emanuelelattanzi/virtual-sense.hardware/1.1.0/VirtualSense_FunctionalDiagram/pict/VirtualSense_MCU_brd_1.1.0.png

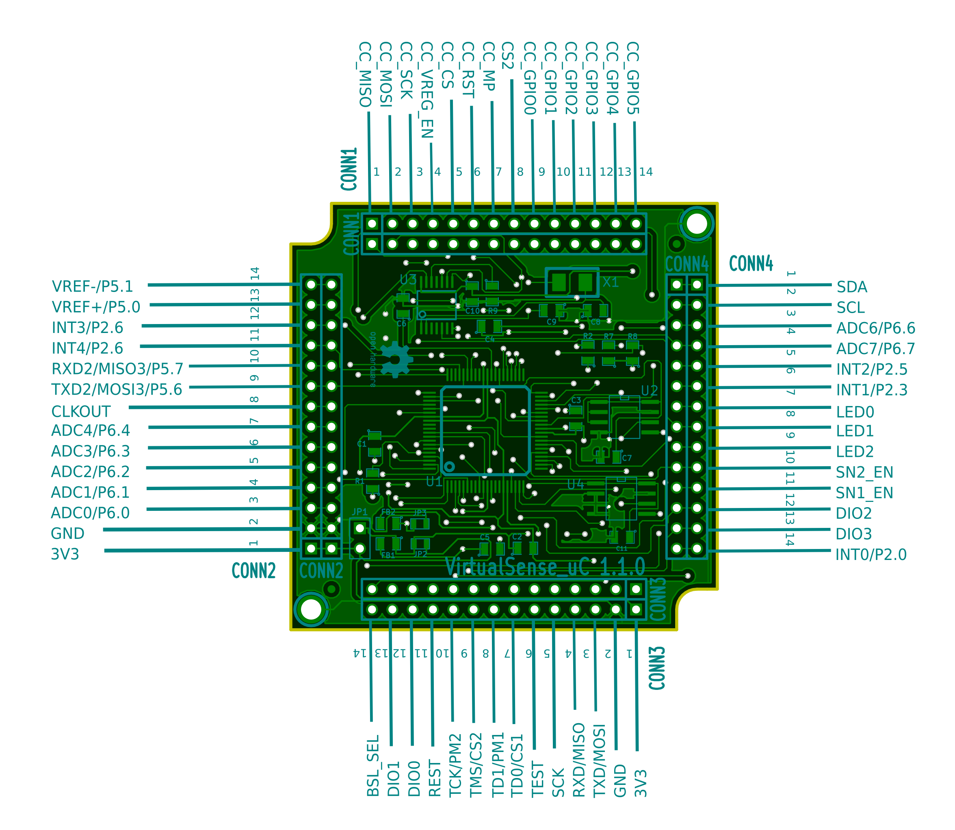
1.1.0/VirtualSense_FunctionalDiagram/pict/VirtualSense_MCU_brd_1.1.0.png
