emanuelelattanzi/virtual-sense.hardware/1.1.0/TestRadio/testradio_BOM_description.xls

Ref. | Part name | Pcs/unit | Description | Manufacturer | Part Number | Comment
ANTENNA
C7 | C_39P_0402_NP0_J_50 | 1 | Capacitor, 39p, 0402, NP0, 5%, 50V | Murata | GRM1555C1H390JZ01
C5 | C_82P_0402_NP0_J_50 | 1 | Capacitor, 82p, 0402, NP0, 5% 50V | Murata | GRM1555C1H820JZ01
C10-C8 | C_1P8_0402_NP0_C_50 | 1 | Capacitor, 1p8, 0402, NP0, +/-0.25pF 50V | Murata | GRM1555C1H1R8CZ01
C9 | C_1P5_0402_NP0_C_50 | 1 | Capacitor, 1p5, 0402, NP0, +-0.25pF, 50V | Murata | GRM1555C1H1R5CZ01
C13 | C_1P0_0402_NP0_C_50 | 3 | Capacitor, 1p, 0402, NP0, +/-0.25pF 50V | Murata | GRM1555C1H1R0CZ01
R6 | R_0_0402 | 1 | Resistor, 0 ohms, 0402 | Koa
U5 | SMA_SMD | 1 | SMA connector, straight SMD-mount | Hus-Tsan Group Taiwan
CC2520
U1 | CC2520 | 1 | Single-chip transceiver | Texas Instruments
C141;C151;C161;C271 | C_100N_0805_X7R_K_10 | 4 | Capacitor, 100n, 0805, X7R, 10%, 10V | Multicomp | MCCA001225
C1 | C_1U_0805_Y5V | 1 | Capacitor 1uF, 0805, Y5V | Multicomp | MCCA000549
C121;C131 | C_27P_0805_NP0_J_50 | 1 | Capacitor, 27p, 0805, NP0, 5%, 50V | Multicomp | MC0805N270J500CT
R1 | R_1M_0805_F | 1 | Resistor, 1M, 0805 | Multicomp | MCMR08X105 JTL
R231 | R_56K_0805_F | 1 | Resistor, 56K, 0805 | Multicomp | MCMR08X563 JTL
R261 | R_4K7_0805_F | 1 | Resistor, 4K7, 0805 | Multicomp | MCMR08X472 JTL
L1 | L_BEAD_102_0805 | 1 | EMI filter bead | Murata | BLM15HG102SN1D | Ordinata 0402
U3 | X_32.000/10/15/30/16 | 1 | Crystal, 32.000MHz,NX3225DA, 10/15ppm, 16 pF | NDK | NX3225DA
