emanuelelattanzi/virtual-sense.hardware/1.1.0/VirtualSense_Ordini_1_1_0_beta.xlsx

Componente |  | Layer | Quantità | Note
MSP430F5418A | U1 | MCU | 1 |  | http://it.farnell.com/texas-instruments/msp430f5418aipn/ic-mcu-16bit-msp430f5x-80lqfp/dp/2081250
QUARZO 32,768K | X1 | MCU | 1 |  | openpicus smd
PCF2123 | U3 | MCU | 1 |  | http://www.digikey.it/product-detail/it/PCF2123TS%2F1,118/568-4534-1-ND/1963421
24AA1025 | U2 | MCU | 1 |  | http://it.farnell.com/microchip/24aa1025-i-sm/eeprom-1-mbit-400khz-8soic/dp/1579569
24AA025E48 | U4 | MCU | 1 |  | http://it.farnell.com/microchip/24aa025e48-i-sn/ic-eeprom-2k-1-8v-8soic/dp/1814890
FDN337N transistor | Q2,Q3,Q4 | MCU | 0 |  | http://it.farnell.com/fairchild-semiconductor/fdn337n/mosfet-n-sot-23/dp/9845356
Condensatori 100nF 0805 | C1,C3,C2,C10,C4,C7,C11 | MCU | 7
Condensatori 18pF 0805 | C8,C9 | MCU | 2
Condensatori 10uF 0805 | C5 | MCU | 1
Condensatori 0,47uF 0805 | C6 | MCU | 1
Resistenze 47K 0805 | R9,R1,R2 | MCU | 3
Resistenze 0ohm 0603 o goccia stagno | JP2,JP3 | MCU | 2
Induttanza BLM15HG102SN1D 0805 | FB1,FB2 | MCU | 2
Resistenze 10K ohm 0805 | R7,R8 | MCU | 2
connettori 14 SIL passanti | più interni | MCU | 4 |  | http://it.farnell.com/jsp/search/productdetail.jsp?SKU=1929543
cc2520 | U1 | Radio | 1 |  | http://it.farnell.com/texas-instruments/cc2520rhdt/ic-transceiver-rf-zigbee-28qfn/dp/1573887
QUARZO 32MHZ smd | U3 | Radio | 1 |  | quarzo openpicus
1Mohm 0805 | R1 | Radio | 1 |  | http://it.farnell.com/welwyn/asc0805-1m0ft5/resistenza-anti-sulphur-0805-1m0/dp/2078975
bias resistor 56K 1% 0805 | R231 | Radio | 1 |  | http://it.farnell.com/johanson-technology/2450at45a100e/antenna-ceramica-2-45ghz/dp/1885499?Ntt=2450AT45A100E
FDN337N transistor mos n | Q4,Q1,Q2 | Radio | 3 |  | http://www.digikey.it/product-detail/it/FDN337N/FDN337NCT-ND/458950
BH1620FVC | BH1620FVC1 | Radio | 1 |  | http://it.farnell.com/rohm/bh1620fvc-tr/ic-ambient-light-sensor-5wsof/dp/1972833?Ntt=BH1620FVC
connettori 14 pin maschio non passante SIL | più interni | Radio | 3
Induttanza BLM15HG102SN1D 0805 | l1 | Radio | 1 |  | http://it.farnell.com/murata/blm15hg102sn1d/ferrite-bead-0402-case-1kohm/dp/1400912
MPL115A2 | U2 | Radio | 1 |  | http://it.farnell.com/freescale-semiconductor/mpl115a2/mini-i2c-digital-barometer-50-to/dp/2102577
led blu 0805 KPT-1608_PBC | D3,D2,D1 | Radio | 3
resistenze 750ohm 0805 | R4,R3,R2 | Radio | 3
Resistenze 47K 0805 | R261 | Radio | 1
resistenze 2K2 0805 | R9 | Radio | 1
Condensatori,0805, 100nF | C2,C11,C4,C141,C151,C161,C271 | Radio | 7
Condensatori,0805, 1uF | C1,C6,C12 | Radio | 3
Condensatori,0805, 27PF, 50V | C121,C131 | Radio | 2 |  | http://it.farnell.com/kemet/c0805c270j5gactu/condensatore-0805-27pf-50v-np0/dp/1414683
Condensatori 0402, 1.5PF, 50V | C7,C8 | Radio | 2 |  | http://it.farnell.com/avx/04025a1r5cat2a/capacitor-0402-1-5pf-50v-np0/dp/1327633
Condensatori,0805, 47PF | C3 | Radio | 1
FTDI FT232 | U1 | Debug | 1 |  | http://www.digikey.it/product-detail/it/FT232RL-REEL/768-1007-2-ND/1836385
PCA9548 tssop24 | U2 | Debug | 1 |  | http://it.farnell.com/nxp/pca9548apw-112/ic-8ch-i2c-bus-switch-5-5v-tssop/dp/1831210
connettore mini USB | J1 | Debug | 1 |  | http://www.digikey.it/product-detail/it/1734035-2/A31727CT-ND/773789
pulsante | Reset1 | Debug | 1 |  | http://it.farnell.com/omron-electronic-components/b3f-3100/interruttore-tattile-spno-pcb/dp/959704
led giallo 0805 KPT-1608_YC | D2 | Debug | 1 |  | il colore non è importante basta che sia diverso da quello sotto, indicano rx e tx dell'ftdi
led rosso 0805 KPT-1608_EC | D1 | Debug | 1
resistenze 750ohm 0805 | R2,R1 | Debug | 2
Resistenze 0ohm 0805 | R5 | Debug | 1
Resistenze 10K 0805 | R3,R4 | Debug | 2
Condensatori,0805, 4,7uF | C2 | Debug | 1
Condensatori,0805,100nF | C4,C3,C1 | Debug | 3
pin_array 90gradi 7x2 | PROG1 | Debug | 1
connettori 14 pin femmina non passante SIL | solo CONN2 più interno | Debug | 1
jumper | JP1,JP2 | Debug | 2
SWITCH_DJ2235 | U3 | Battery | 1 |  | adimpex
BH411-1P | U1,U2 | Battery | 2 |  | adimpex
connettori 14 pin femmina non passante SIL | i 2 più interni | Battery | 2
Resistenze 1Mohm 0805 | R12,R11,R10 | audiotrigger | 3
Condensatore 100n 0805 | C21,C22 | audiotrigger | 2
connettori 14 pin femmina non passante SIL | più interni | audiotrigger | 3
PN2222ABU | Q1 | audiotrigger | 1
KSP97BU | Q2 | audiotrigger | 1
PIC12LF1840 | U6 | audiotrigger | 1
FDN337N transistor | Q3 | audiotrigger | 1
Resistenze 9Mohm 0805 | R5 | audiotrigger | 1
Trimmer T93YA 20kohm | RV1 | audiotrigger | 1
K4000001 transformer | T1,T2 | audiotrigger | 2
Condensatore 1.5n 0805 | C15,C16 | audiotrigger | 2
MCP6541 MSOP_8 | U1 | audiotrigger | 1
400SR ultrasonic receiver | SP1 | audiotrigger | 1
400PT ultrasonic receiver | SP2 | audiotrigger | 1
connettori 14 pin maschio non passante SIL | i 2 più interni | testlayer | 2
Connettore micro SD MOLEX 500901-0801 | U1 | testlayer | 1
TRF7970A QFN32-5x5 | U2 | testlayer | 1
Condensatore 180pF 0805 | C1 | testlayer | 1
Condensatore 10pF 0805 | C9 | testlayer | 1
Condensatore 220pF 0805 | C6 | testlayer | 1
Condensatore 680pF 0805 | C7,C8 | testlayer | 1
Condensatore 100pF 0805 | C5 | testlayer | 1
Condensatore 27pF 0805 | C4,C25,C22 | testlayer | 3
Condensatore 280pF 0805 | C3 | testlayer | 1
Condensatore 35pF 0805 | C2 | testlayer | 1
Condensatore 1.2pF 0805 | C13,C12 | testlayer | 2
Condensatore 10nF 0805 | C23,C18,C14,C8,C11 | testlayer | 5
Condensatore 2.2uF 0805 | C24,C15,C19,C10 | testlayer | 4
Condensatore 27uF 0805 | C20,C21 | testlayer | 2
Condensatore 1.5nF 0805 | C17,C16 | testlayer | 2
Resistenze 0ohm 0805 | R1,R8,R9 | testlayer | 3
Resistenze 50K 0805 | R6,R2,R3,R4,R5 | testlayer | 5
Resistenze 100ohm 0805 | R7,R8 | testlayer | 1
Induttanza 560nH | L1 | testlayer | 1
Induttanza 150nH | L3 | testlayer | 1
Induttanza 330nH | L2 | testlayer | 1
connettori 5pin femmina non passante SIL | BLTH1 | testlayer | 1
QUARZO 13.56MHz HC-49V | X1 | testlayer | 1
