emanuelelattanzi/virtual-sense.hardware/1.1.0/TestRadio/note.txt

TODO:

- Modificare isolamento primo balun
