emanuelelattanzi/virtual-sense.hardware/1.1.0/TestLayer/pdf/VirtualSense_TL.pdf

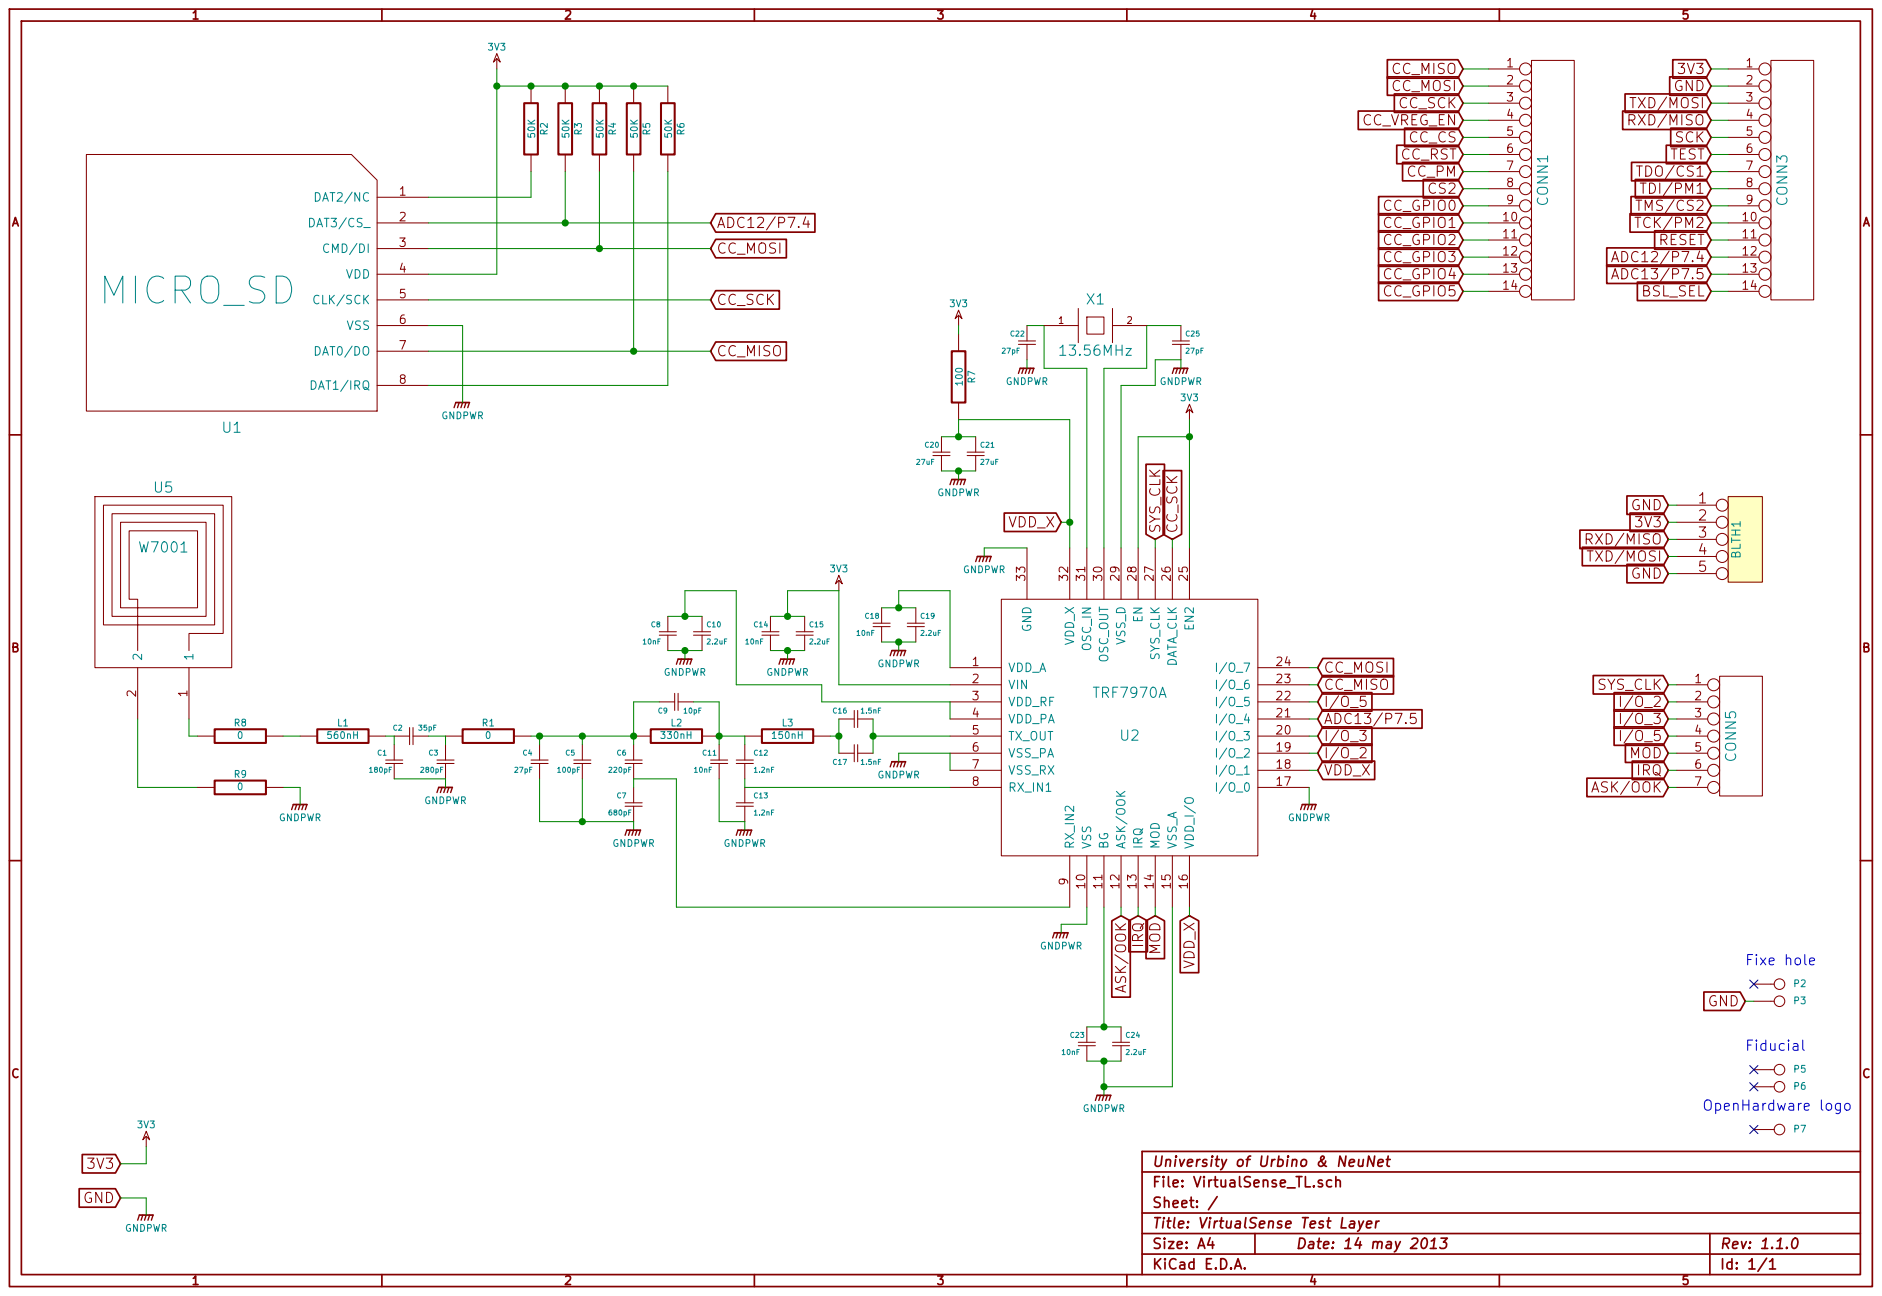
[picture p7: page 1]

I/O_5 MOD IRQ ASK/OOK

University of Urbino & NeuNet
File: VirtualSense_TL.sch
Sheet: /
Title: VirtualSense Test Layer
KiCad E.D.A.
