emanuelelattanzi/virtual-sense.hardware/1.1.0/AudioTrigger/pdf/home-matteo-Dropbox-VirtualSense-1.1.0-AudioTrigger-VirtualSense_AT.pdf

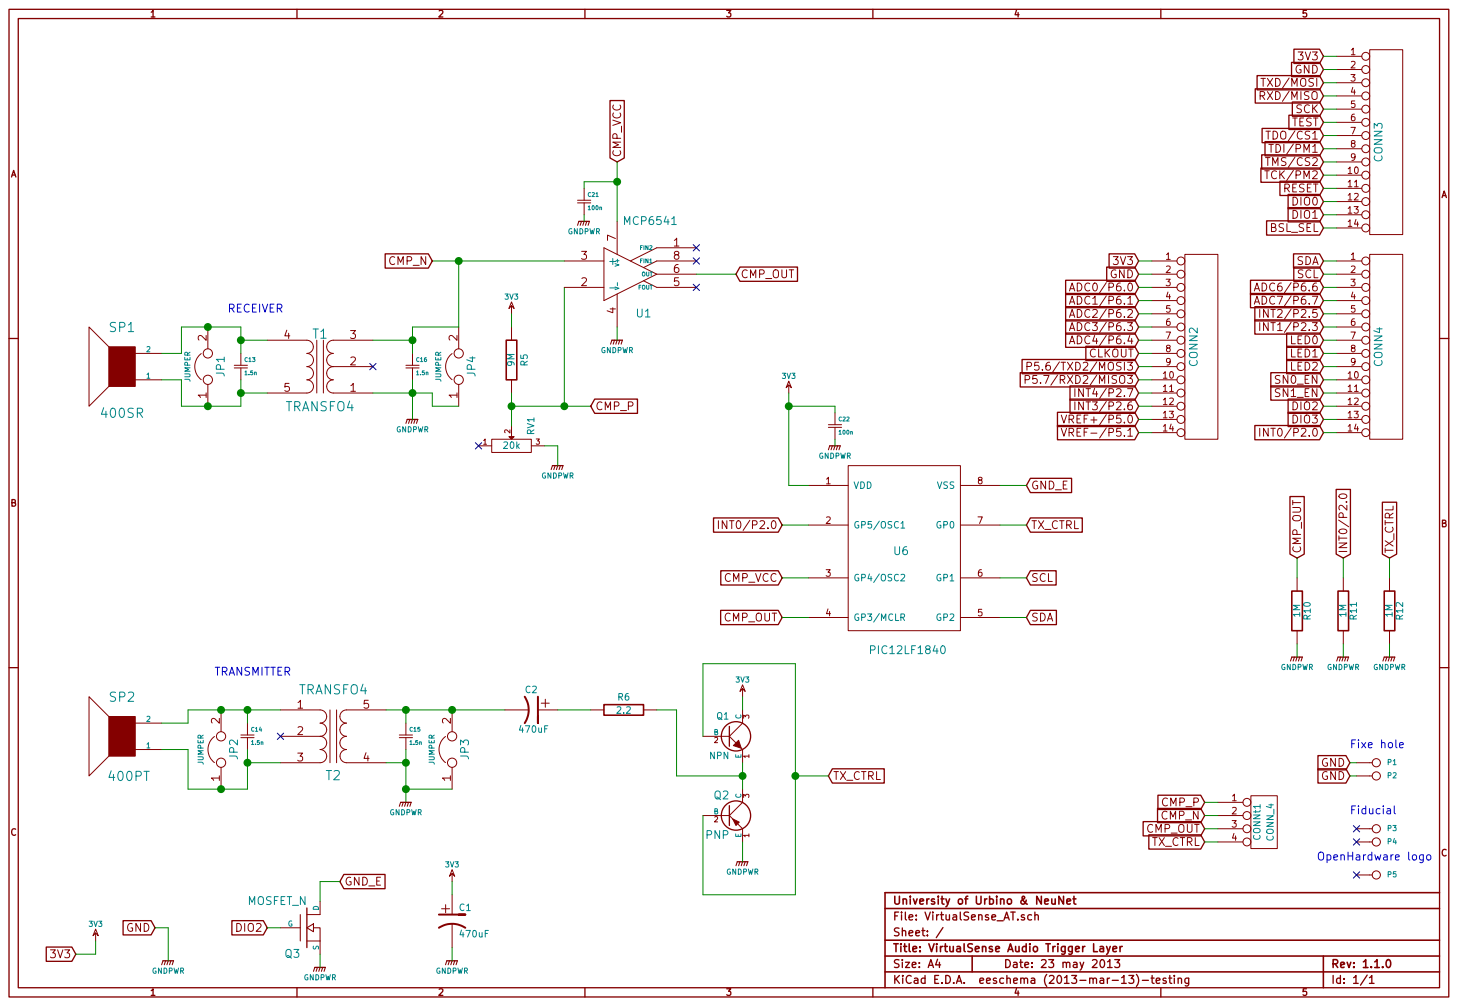
[picture p8: page 1]

2 JP2 JUMPER 1 2 JP3 JUMPER 1 2 JP1 JUMPER 1 2 JP4 JUMPER

University of Urbino & NeuNet
File: VirtualSense_AT.sch
Sheet: /
Id: 1/1 Title: VirtualSense Audio Trigger Layer
KiCad E.D.A. eeschema (2013-mar-13)-testing
