emanuelelattanzi/virtual-sense.hardware/1.1.0/Battery/pdf/VirtualSense_BT.pdf

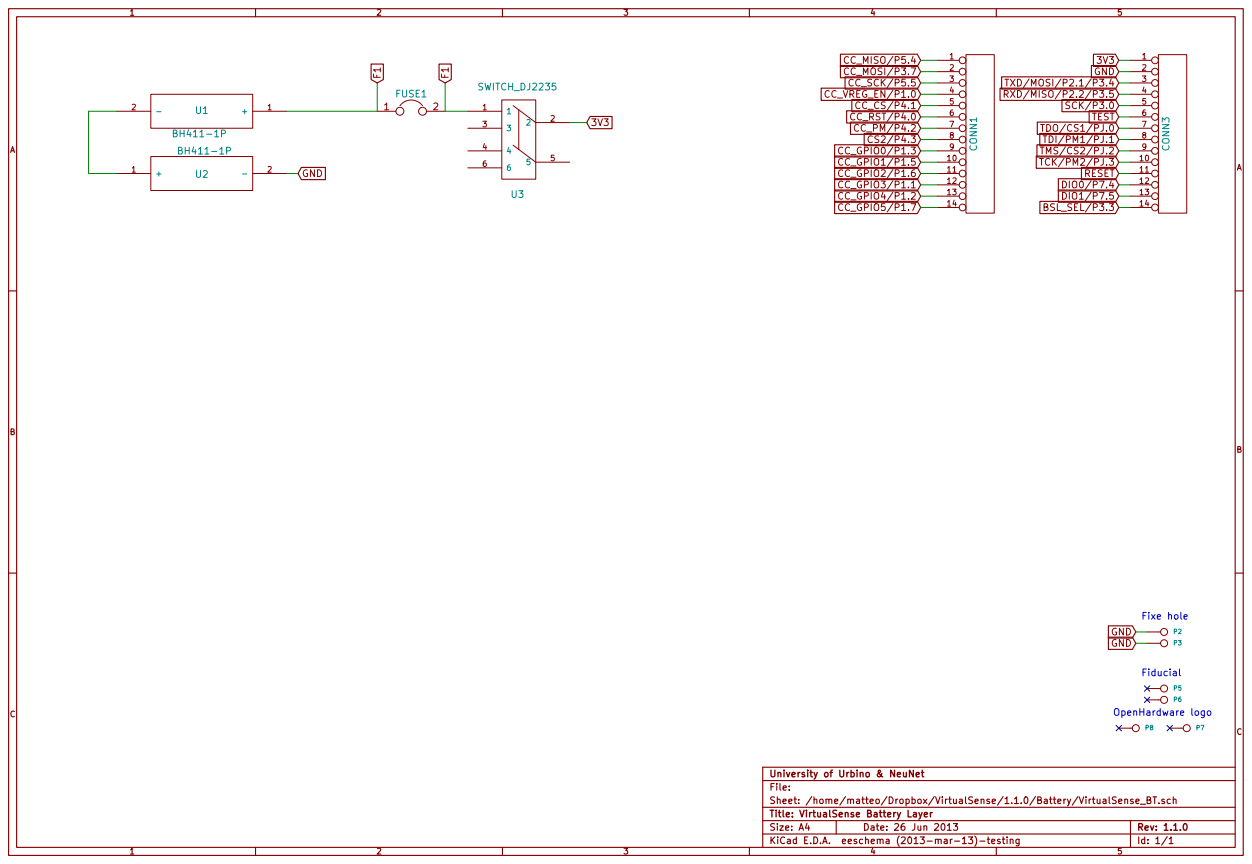
[picture p9: page 1]

C University of Urbino & NeuNet

Sheet: /home/matteo/Dropbox/VirtualSense/1.1.0/Battery/VirtualSense_BT.sch File: Title: VirtualSense Battery Layer
