emanuelelattanzi/virtual-sense.hardware/1.1.0/ProgDebug/pdf/VirtualSense_PD.pdf

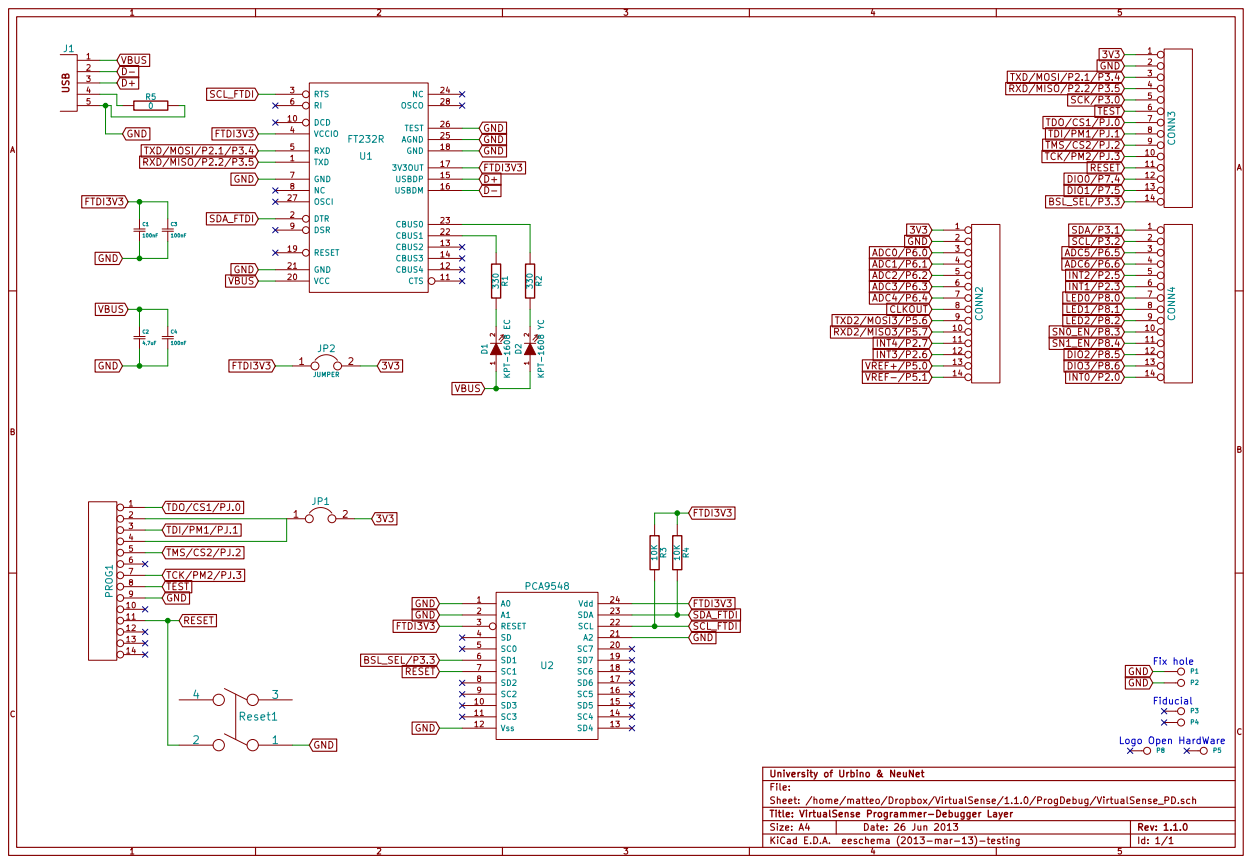
[picture p10: page 1]

1 2 D1 KPT-1608 EC 1 2 D2 KPT-1608 YC

C University of Urbino & NeuNet

Sheet: /home/matteo/Dropbox/VirtualSense/1.1.0/ProgDebug/VirtualSense_PD.sch File: Title: VirtualSense Programmer-Debugger Layer
