emanuelelattanzi/virtual-sense.hardware/1.1.0/AudioDSP/pdf/VS-DSP_bottom_assembly.pdf

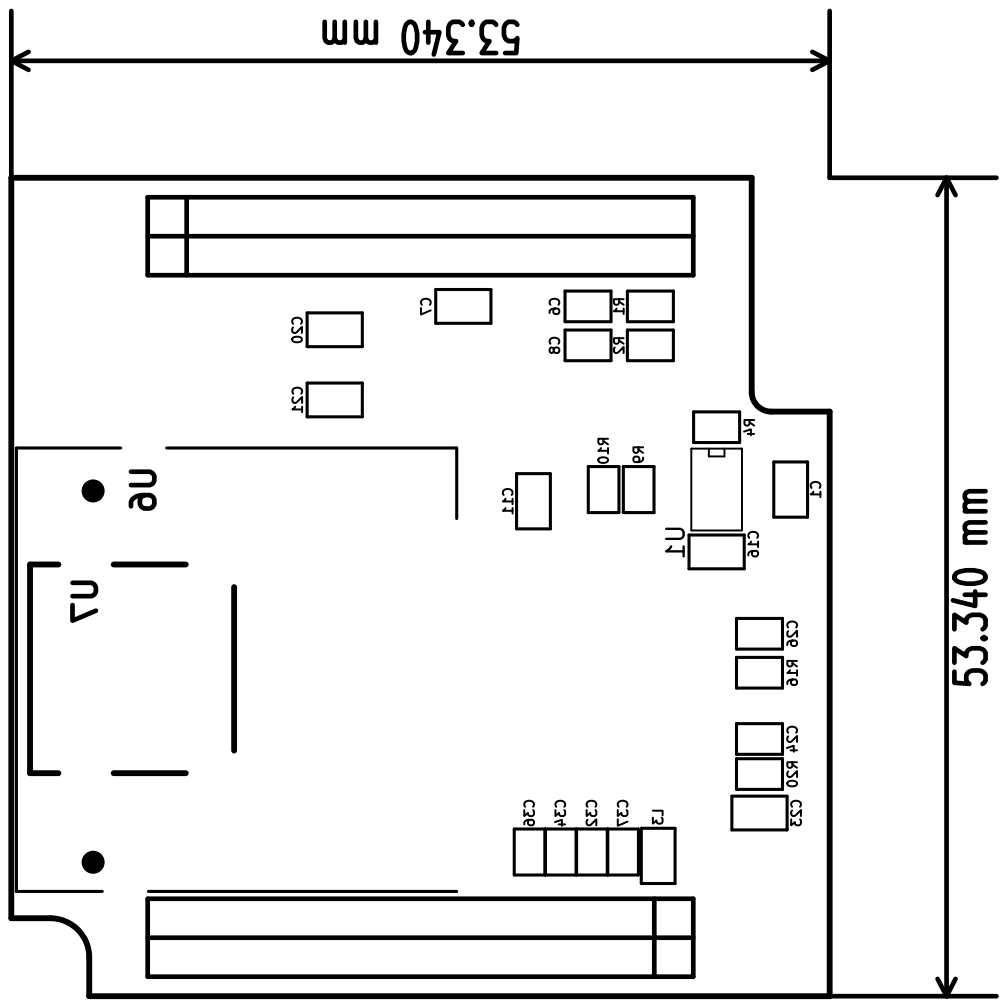
[picture p11: page 1]
