emanuelelattanzi/virtual-sense.hardware/1.1.0/AudioDSP/pdf/VS-DSP_top-assembly.pdf

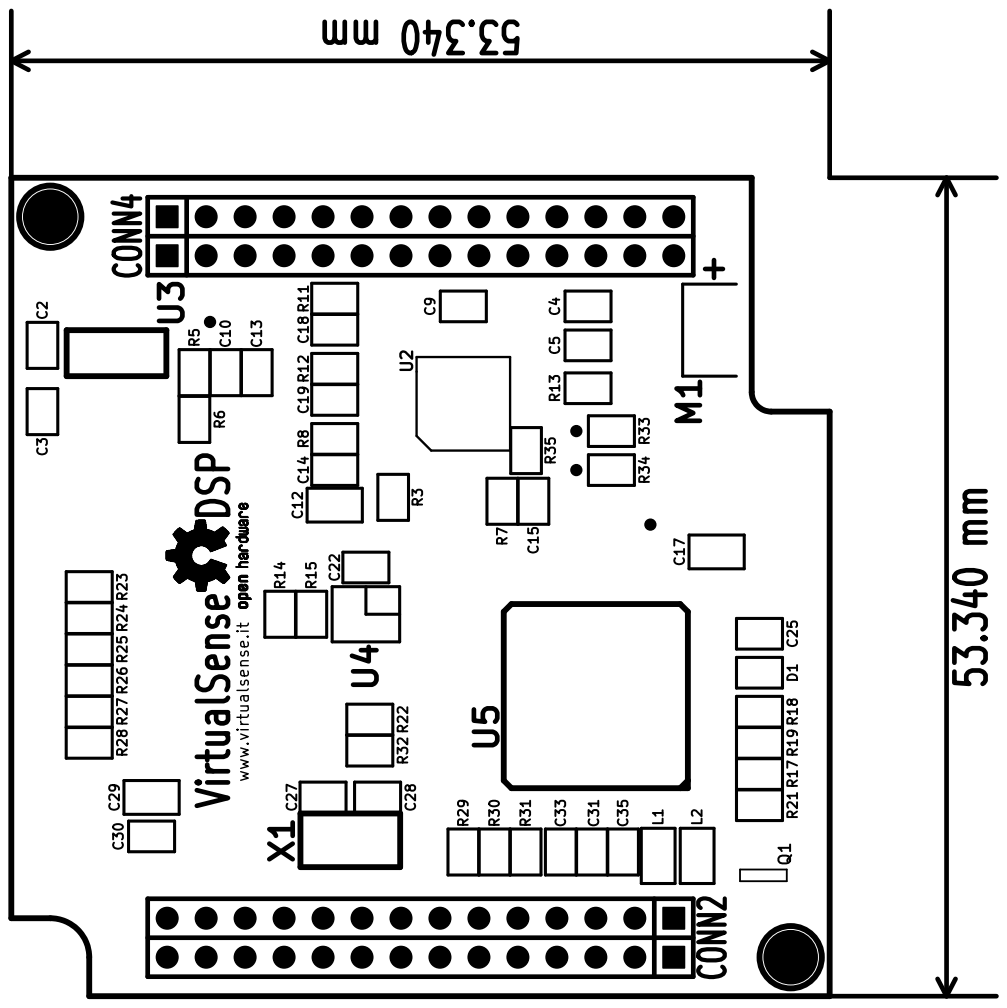
[picture p12: page 1]
