emanuelelattanzi/virtual-sense.hardware/1.1.0/AudioTrigger/pdf/VirtualSense_AT.pdf

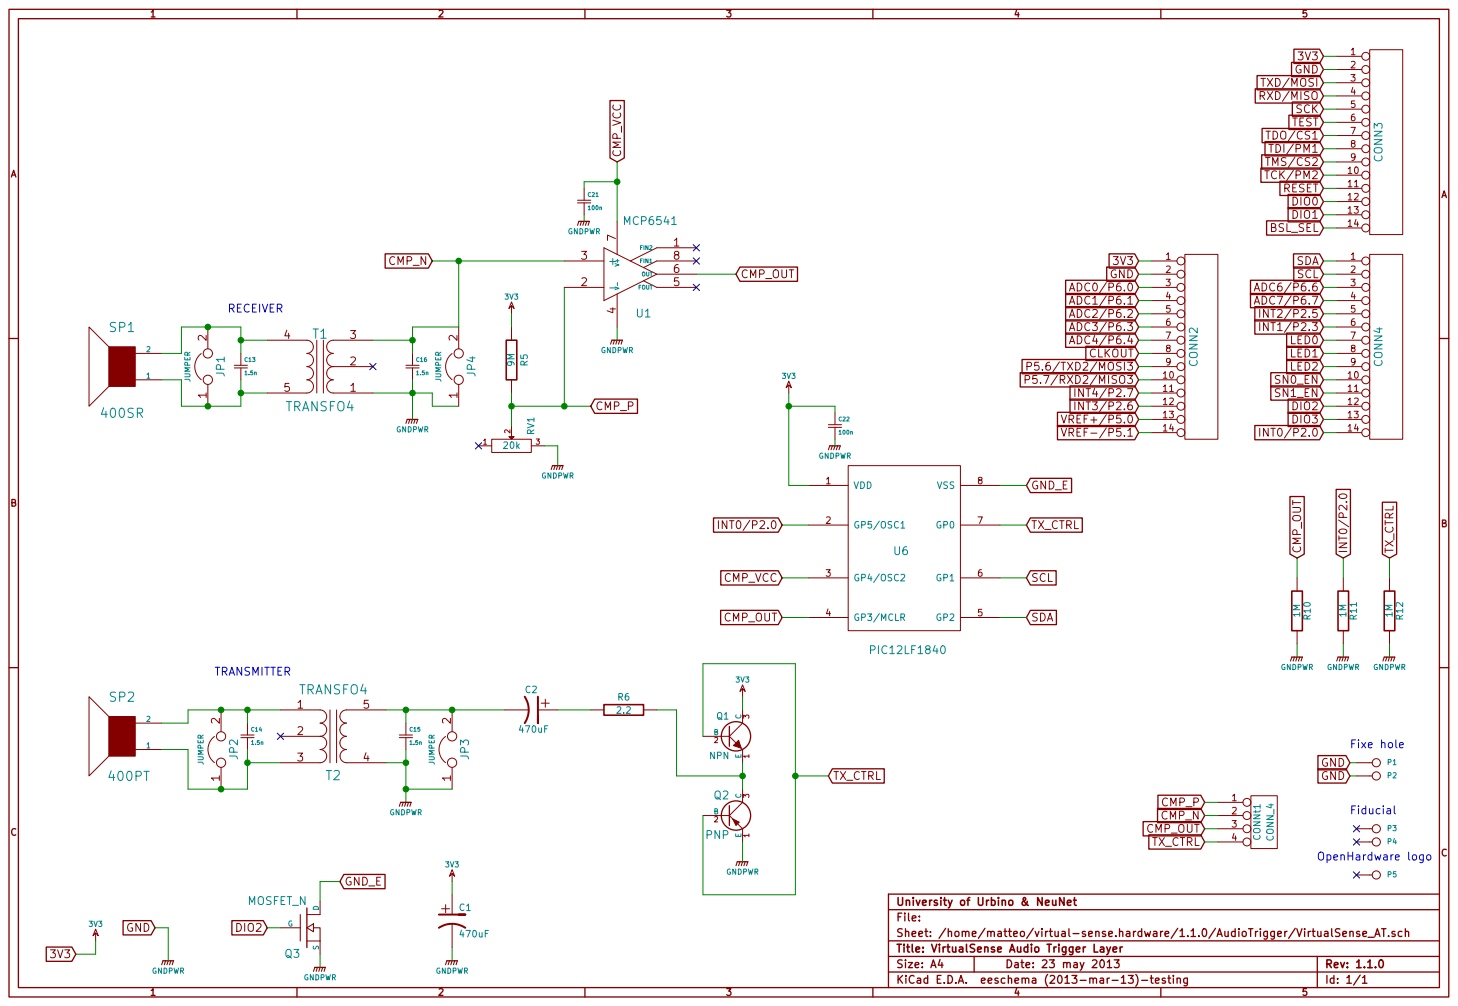
[picture p13: page 1]

2 JP2 JUMPER 1 2 JP3 JUMPER 1 2 JP1 JUMPER 1 2 JP4 JUMPER

C University of Urbino & NeuNet

Sheet: /home/matteo/virtual-sense.hardware/1.1.0/AudioTrigger/VirtualSense_AT.sch File: Title: VirtualSense Audio Trigger Layer
