emanuelelattanzi/virtual-sense.hardware/1.1.0/AudioDSP/pdf/VirtualSense_TADSP.pdf

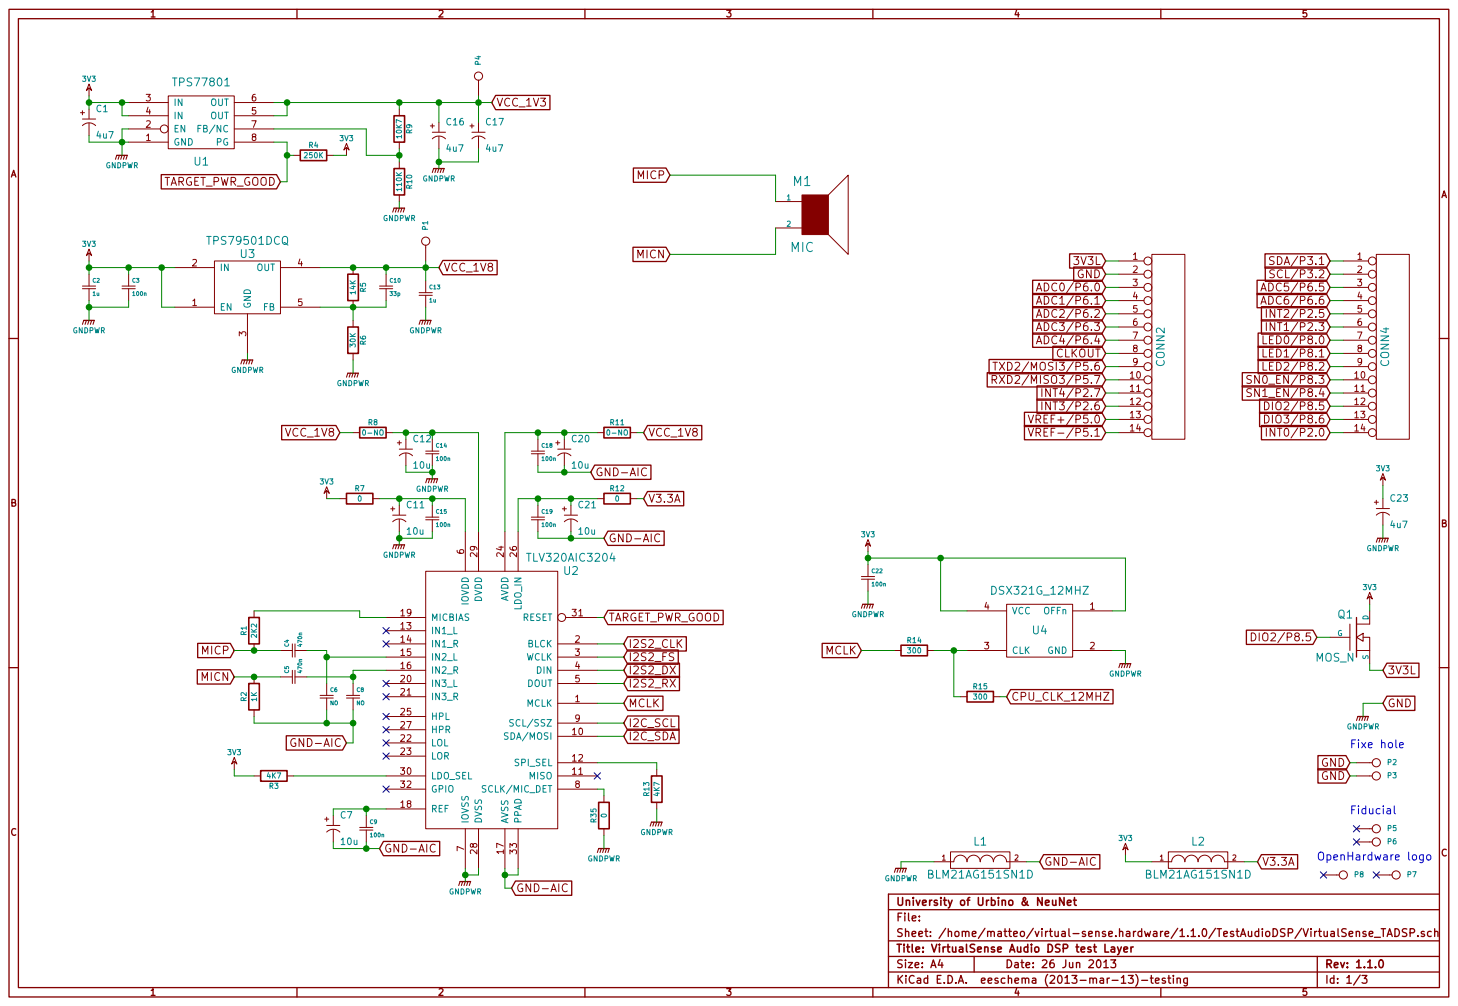
[picture p14: page 1]

7 SCLK/MIC_DET 8 SCL/SSZ 9 SDA/MOSI 10

C University of Urbino & NeuNet

Sheet: /home/matteo/virtual-sense.hardware/1.1.0/TestAudioDSP/VirtualSense_TADSP.sch File: Title: VirtualSense Audio DSP test Layer

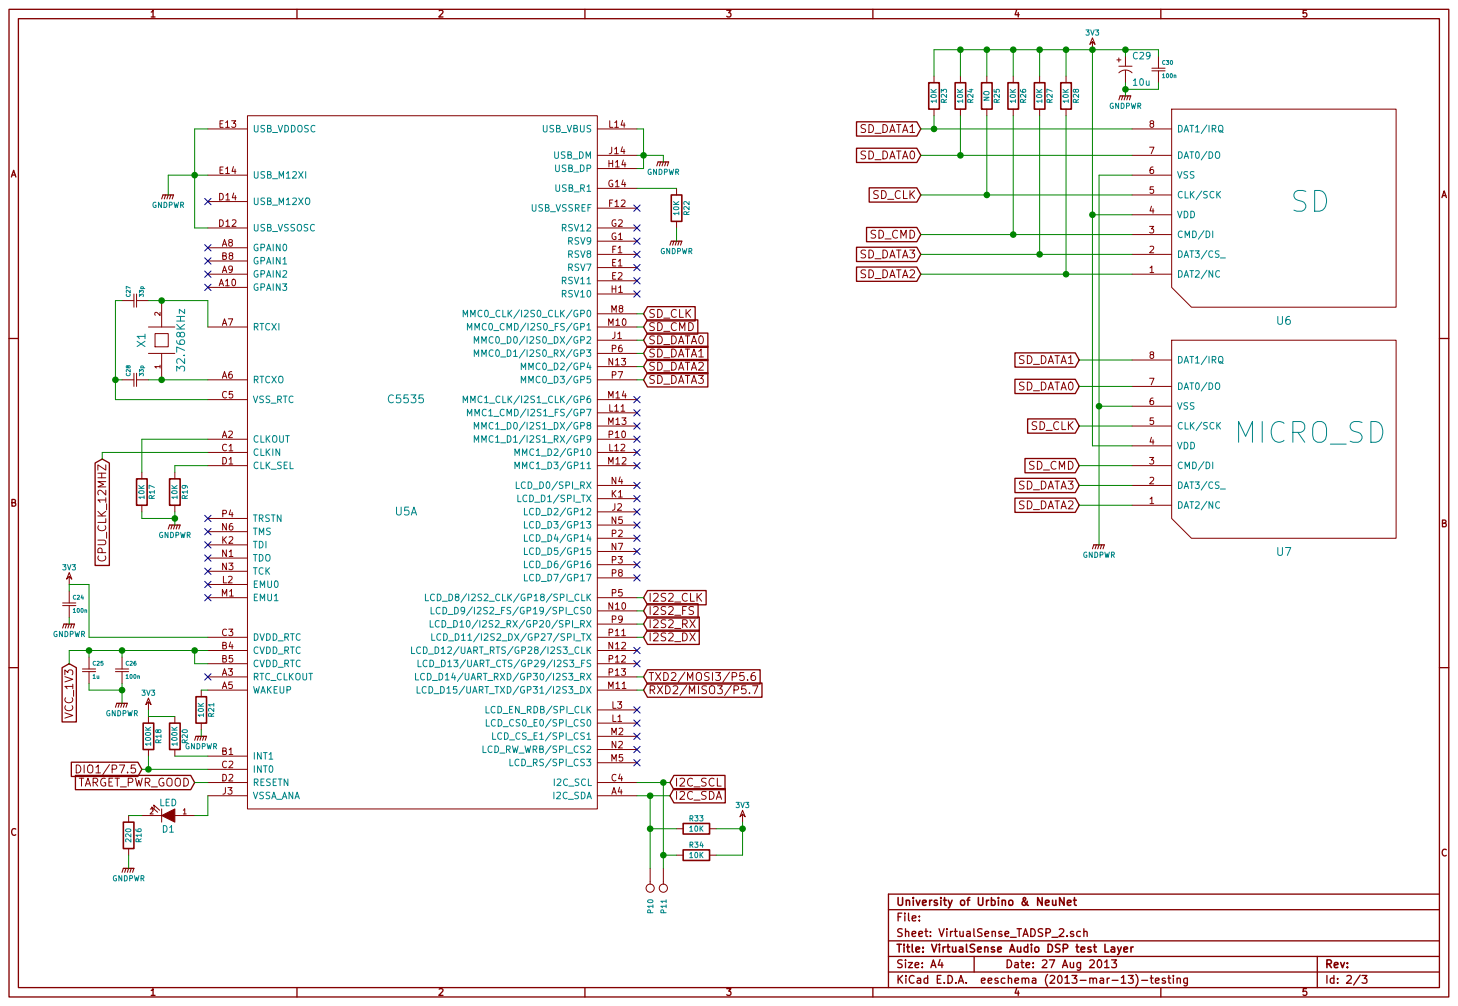
[picture p15: page 2]

Sheet: VirtualSense_TADSP_2.sch File: Title: VirtualSense Audio DSP test Layer

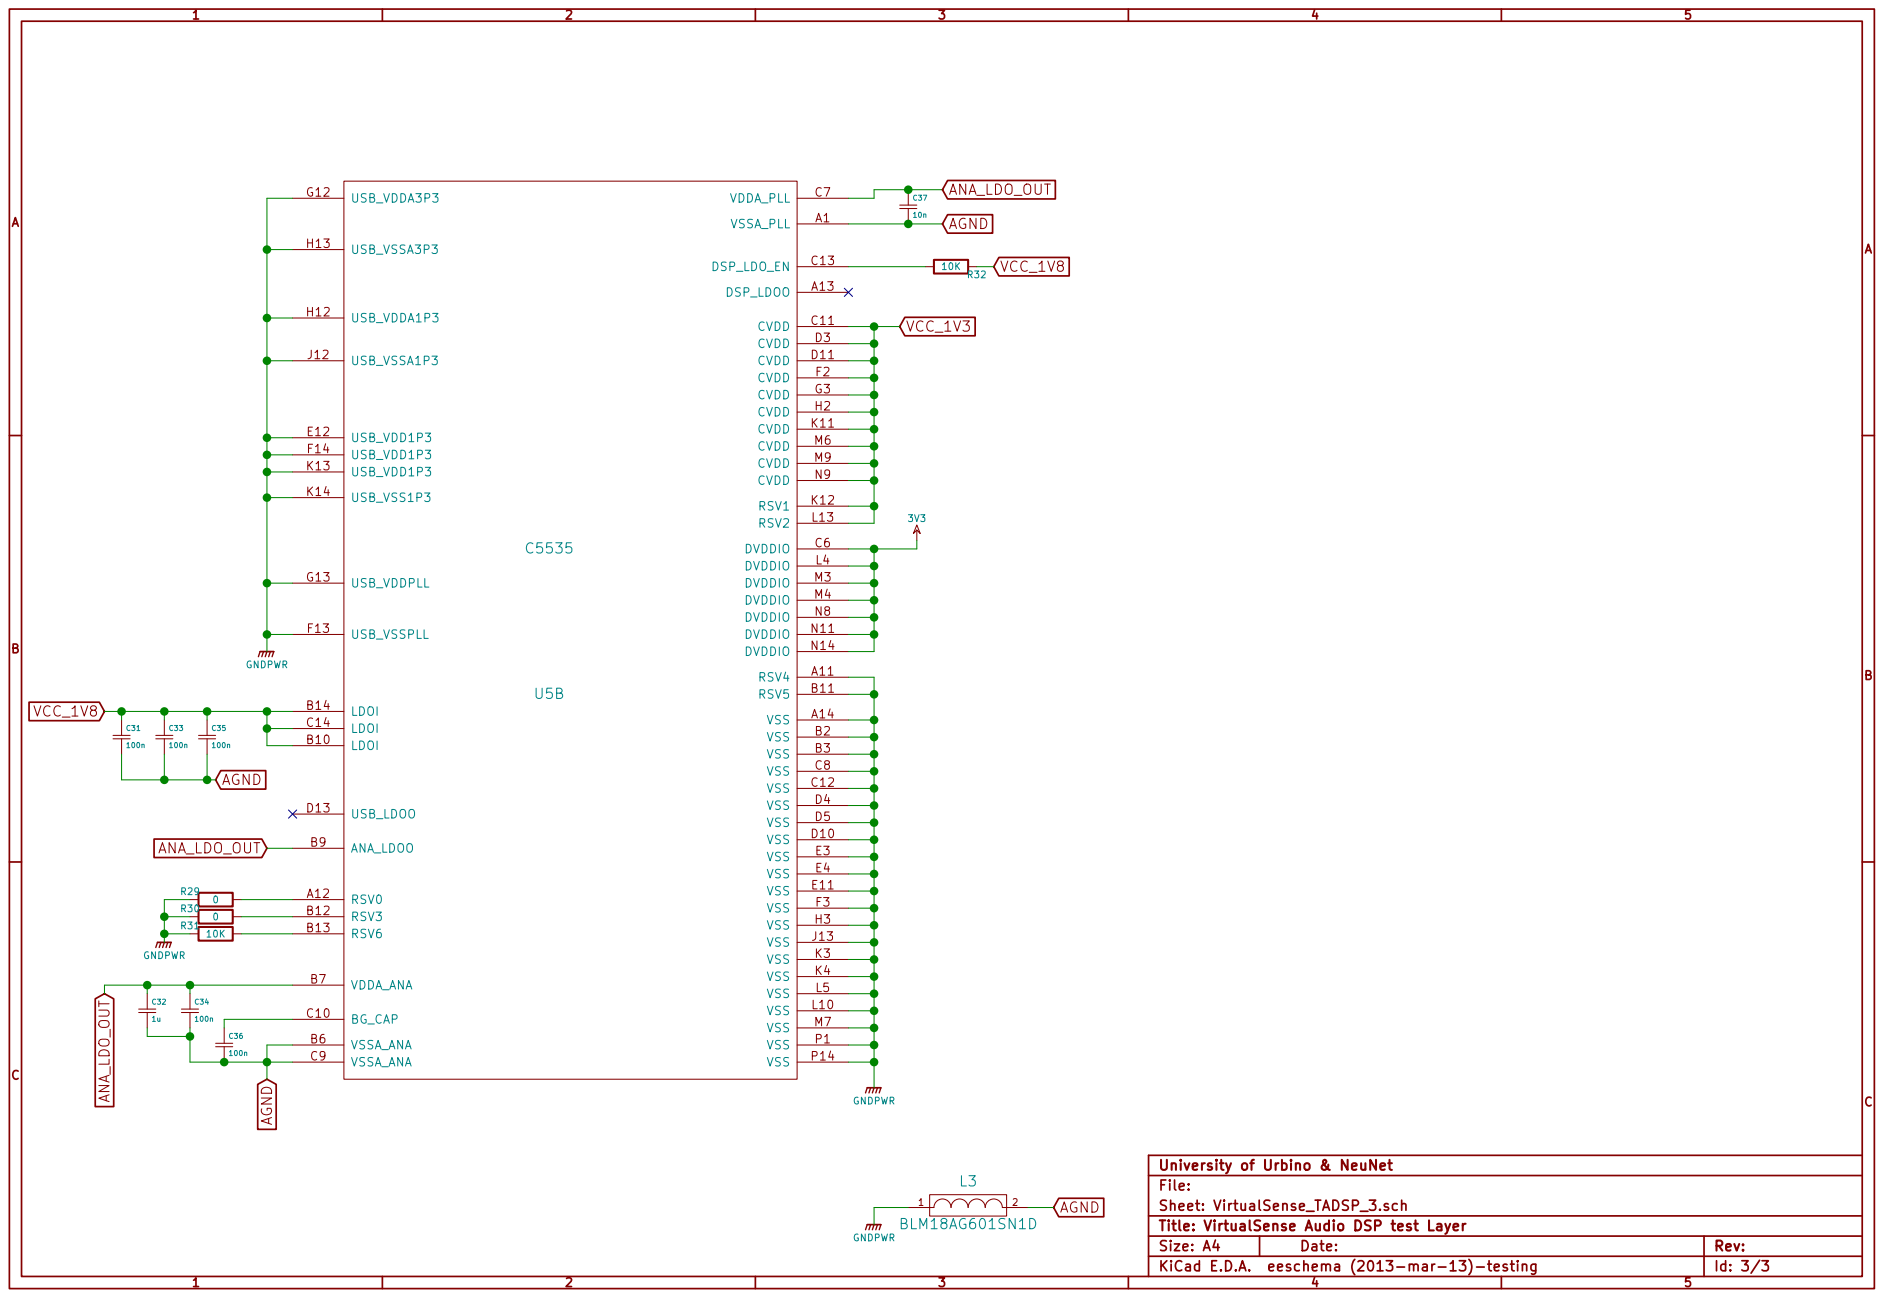
[picture p16: page 3]

Sheet: VirtualSense_TADSP_3.sch File: Title: VirtualSense Audio DSP test Layer
