emanuelelattanzi/virtual-sense.hardware/1.1.0/MCU/pdf/VirtualSense_MCU.pdf

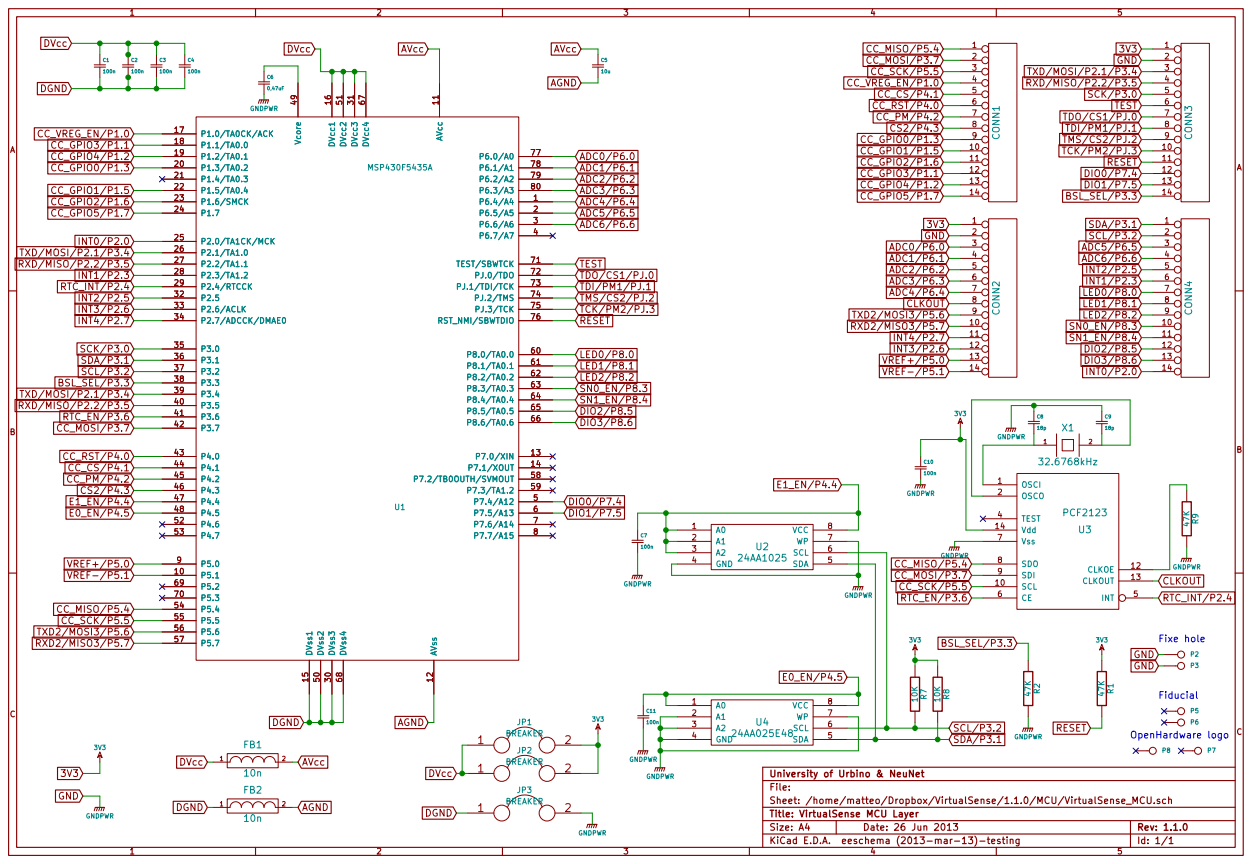
[picture p17: page 1]

C University of Urbino & NeuNet

Sheet: /home/matteo/Dropbox/VirtualSense/1.1.0/MCU/VirtualSense_MCU.sch File: Title: VirtualSense MCU Layer
