emanuelelattanzi/virtual-sense.hardware/1.1.0/RadioTransceiverDipole/pdf/VirtualSense_RTRD.pdf

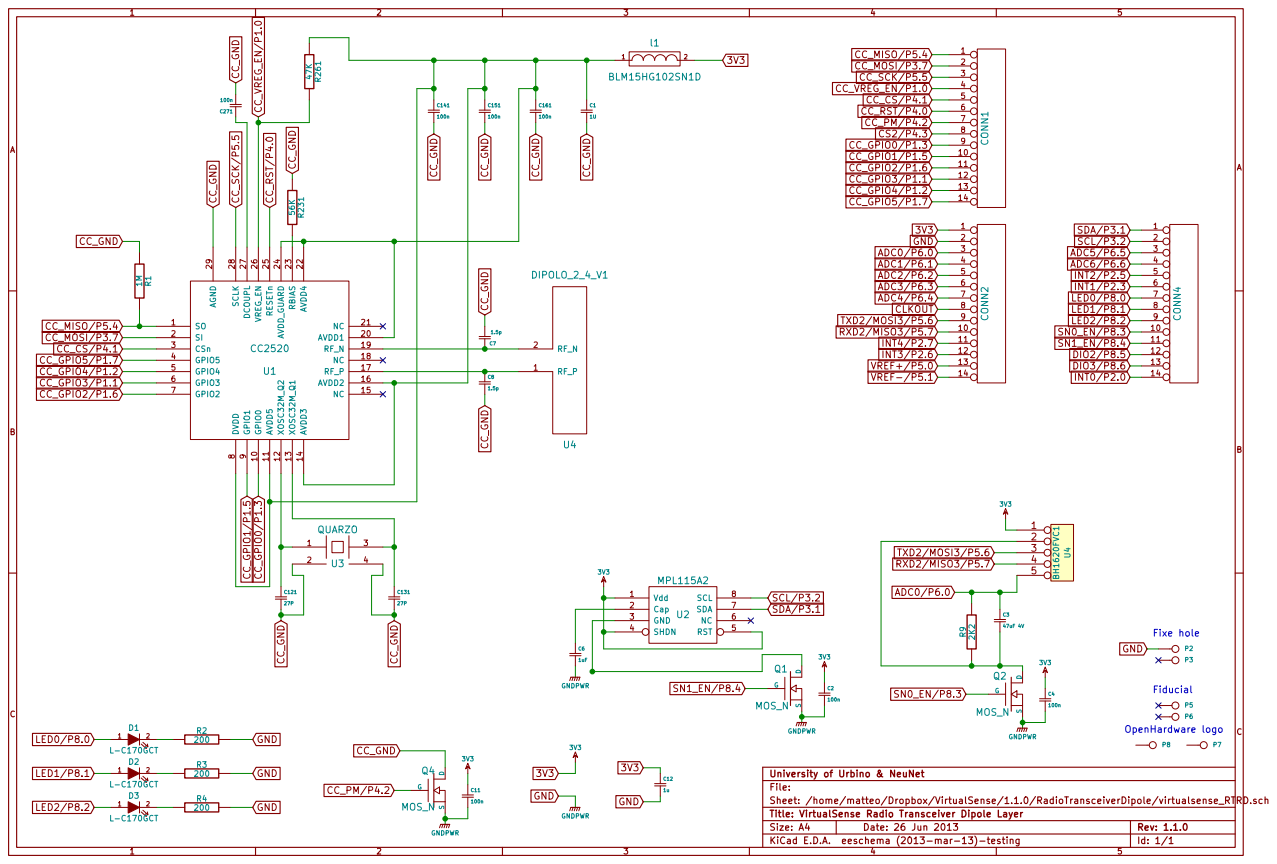
[picture p18: page 1]

9 GPIO0 10 AVDD1 20 AVDD5 11 NC 21 XOSC32M_Q2 12 AVDD4 22 XOSC32M_Q1 13 RBIAS 23 AVDD3 14 AVDD_GUARD 24 NC 15 RESETn 25 AVDD2 16 VREG_EN 26 RF_P 17 DCOUPL 27 NC 18 SCLK 28 RF_N 19 AGND 29 U1 CC2520 CC_GND 47K R261

C University of Urbino & NeuNet
GNDPWR

Sheet: /home/matteo/Dropbox/VirtualSense/1.1.0/RadioTransceiverDipole/virtualsense_RTRD.sch File: Title: VirtualSense Radio Transceiver Dipole Layer
