emanuelelattanzi/virtual-sense.hardware/(list of files, drawings)

Other design files:
1.1.0/AudioDSP/VirtualSense_ADSP-test_clearance.dsn
1.1.0/AudioDSP/VirtualSense_ADSP.dsn
1.1.0/AudioTrigger/VirtualSense_AT.dsn
1.1.0/Battery/VirtualSense_BT.dsn
1.1.0/ProgDebug/VirtualSense_PD.dsn
1.1.0/RadioTransceiverDipole/VirtualSense_RTRD.dsn
1.1.0/TestLayer/VirtualSense_TL.dsn
1.1.0/TestRadio/VirtualSense_RT.dsn
