emanuelelattanzi/virtual-sense.hardware/1.1.0/AudioDSP/VirtualSense_ADSP.sch

## KiCad design 1.1.0/AudioDSP/VirtualSense_ADSP.sch (2014-02-13, an earlier design)

Schematic: VirtualSense_ADSP.sch

Parts:
BT1: WAKEUP
BT2: 1V5
C1: 1u
C4, C5: 470n
C6, C8: NO
C7, C11, C21: 10u
C9, C15, C19, C22: 100n
C23: 4u7
CONN1: VBAT
CONN2, CONN4: CONN_14
L1, L2: BLM21AG151SN1D
M1: MIC
P2, P3, P5, P6: CONN_1
P7: DSP
P8: uC
Q1: MOS_N
R1: 2K2
R2: 1K
R3, R13: 4K7
R7, R12, R35: 0
R14: 300
U2: TLV320AIC3204
U4: DSX321G_12MHZ

Notes on the sheet:
Fixe hole
Fiducial
OpenHardware logo
