emanuelelattanzi/virtual-sense.hardware/1.1.0/AudioDSP/VirtualSense_ADSP_2.sch

## KiCad design 1.1.0/AudioDSP/VirtualSense_ADSP_2.sch (2014-02-13, an earlier design)

Schematic: VirtualSense_ADSP_2.sch

Parts:
BT1: 1V3
C24, C26, C30: 100n
C25: 1u
C27, C28: 33p
C29: 10u
D1: LED
P10: DSP-SDA
P11: DSP-SCL
R16: 220
R17, R19, R21, R22, R23, R24, R26, R27, R28, R33, R34: 10K
R18, R20: 100K
R25: NO
U5: C5535
U6: SD
U7: MICRO_SD
X1: 32.768KHz
