emanuelelattanzi/virtual-sense.hardware/1.1.0/AudioDSP/VirtualSense_ADSP_3.sch

## KiCad design 1.1.0/AudioDSP/VirtualSense_ADSP_3.sch (2014-02-13, an earlier design)

Schematic: VirtualSense_ADSP_3.sch

Parts:
C31, C33, C34, C35, C36: 100n
C32: 1u
C37: 10n
L3: BLM18AG601SN1D
R29, R30: 0
R31: 10K
U5: C5535
