emanuelelattanzi/virtual-sense.hardware/1.1.0/AudioTrigger/VirtualSense_AT.sch

## KiCad design 1.1.0/AudioTrigger/VirtualSense_AT.sch (2013-07-30)

Schematic: VirtualSense_AT.sch

Parts:
C1, C2: 470uF
C13, C14, C15, C16: 1.5n
C21, C22: 100n
CONN2, CONN3, CONN4, CONN21, CONN31, CONN41: CONN_14
CONNt1: CONN_4
JP1, JP2, JP3, JP4: JUMPER
P1, P2, P3, P4, P5: CONN_1
Q1: NPN
Q2: PNP
Q3: MOSFET_N
R5: 9M
R6: 2.2
R10, R11, R12: 1M
RV1: 20k
SP1: 400SR
SP2: 400PT
T1, T2: TRANSFO4
U1: MCP6541
U6: PIC12LF1840

Notes on the sheet:
Fixe hole
Fiducial
OpenHardware logo
RECEIVER
TRANSMITTER
