emanuelelattanzi/virtual-sense.hardware/1.1.0/Battery/VirtualSense_BT.sch

## KiCad design 1.1.0/Battery/VirtualSense_BT.sch (2013-07-30)

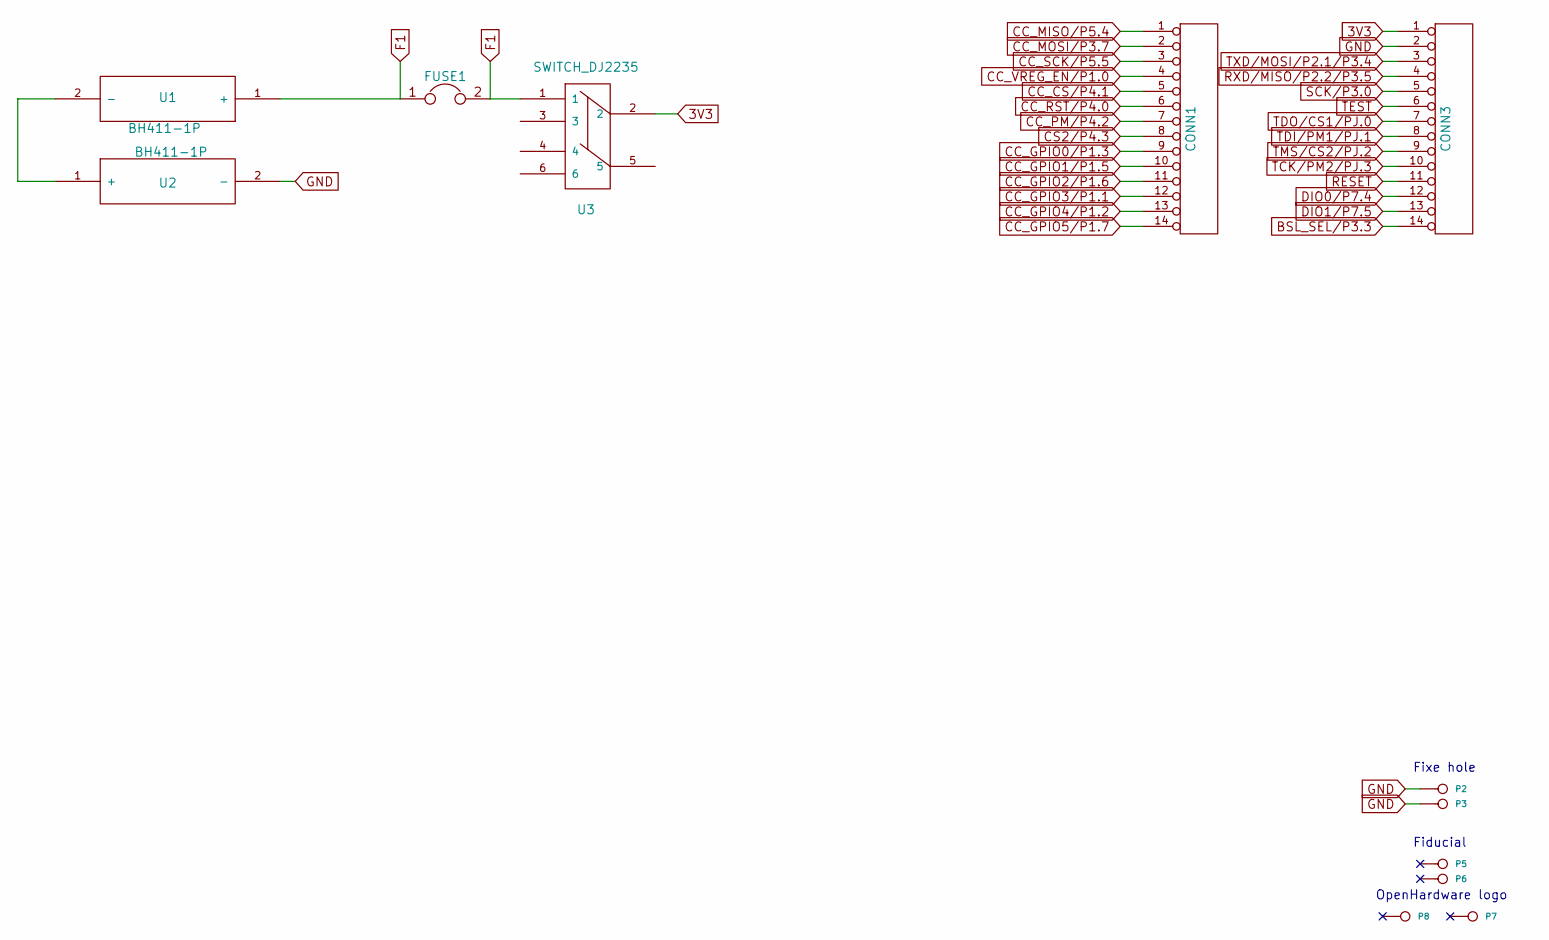
[picture p19: schematic VirtualSense_BT.sch]

Parts:
CONN1, CONN3: CONN_14
FUSE1: JUMPER
P2, P3, P5, P6: CONN_1
P7, P8: BT
U1, U2: BH411-1P
U3: SWITCH_DJ2235

Connections:
3V3: CONN3.1, U3.2
BSL_SEL/P3.3: CONN3.14
CC_CS/P4.1: CONN1.5
CC_GPIO0/P1.3: CONN1.9
CC_GPIO1/P1.5: CONN1.10
CC_GPIO2/P1.6: CONN1.11
CC_GPIO3/P1.1: CONN1.12
CC_GPIO4/P1.2: CONN1.13
CC_GPIO5/P1.7: CONN1.14
CC_MISO/P5.4: CONN1.1
CC_MOSI/P3.7: CONN1.2
CC_PM/P4.2: CONN1.7
CC_RST/P4.0: CONN1.6
CC_SCK/P5.5: CONN1.3
CC_VREG_EN/P1.0: CONN1.4
CS2/P4.3: CONN1.8
DIO0/P7.4: CONN3.12
DIO1/P7.5: CONN3.13
F1: FUSE1.1, FUSE1.2, U1.1 (+), U3.1
GND: CONN3.2, P2.1, P3.1, U2.2 (-)
unnamed: U1.2 (-), U2.1 (+)
RESET: CONN3.11
RXD/MISO/P2.2/P3.5: CONN3.4
SCK/P3.0: CONN3.5
TCK/PM2/PJ.3: CONN3.10
TDI/PM1/PJ.1: CONN3.8
TDO/CS1/PJ.0: CONN3.7
TEST: CONN3.6
TMS/CS2/PJ.2: CONN3.9
TXD/MOSI/P2.1/P3.4: CONN3.3

Notes on the sheet:
Fixe hole
Fiducial
OpenHardware logo
