emanuelelattanzi/virtual-sense.hardware/1.1.0/MCU/VirtualSense_MCU.sch

## KiCad design 1.1.0/MCU/VirtualSense_MCU.sch (2013-07-30)

Schematic: VirtualSense_MCU.sch

Parts:
C1, C2, C3, C4, C7, C10, C11: 100n
C5: 10u
C6: 0,47uF
C8, C9: 18p
CONN1, CONN2, CONN3, CONN4: CONN_14
FB1, FB2: 10n
JP1, JP2, JP3: BREAKER
P2, P3, P5, P6: CONN_1
P7, P8: uC
R1, R2, R9: 47K
R7, R8: 10K
U1: MSP430F5435A
U2: 24AA1025
U3: PCF2123
U4: 24AA025E48
X1: 32.6768kHz

Notes on the sheet:
Fixe hole
Fiducial
OpenHardware logo
