emanuelelattanzi/virtual-sense.hardware/1.1.0/ProgDebug/VirtualSense_PD.sch

## KiCad design 1.1.0/ProgDebug/VirtualSense_PD.sch (2013-07-30)

Schematic: VirtualSense_PD.sch

Parts:
C1, C3, C4: 100nF
C2: 4,7uF
CONN2, CONN3, CONN4: CONN_14
D1: KPT-1608 EC
D2: KPT-1608 YC
J1: USB_3
JP1, JP2: JUMPER
P1, P2, P3, P4: CONN_1
P5, P8: PD
PROG1: CONN_14
R1, R2: 330
R3, R4: 10K
R5: 0
Reset1: Reset
U1: FT232R
U2: PCA9548

Notes on the sheet:
Fix hole
Fiducial
Logo Open HardWare
