emanuelelattanzi/virtual-sense.hardware/1.1.0/RadioTransceiverDipole/VirtualSense_RTRD.sch

## KiCad design 1.1.0/RadioTransceiverDipole/VirtualSense_RTRD.sch (2013-07-30)

Schematic: VirtualSense_RTRD.sch

Parts:
BH1620FVC1: U4
C1: 1U
C2, C4, C11, C141, C151, C161, C271: 100n
C3: 47uF 4V
C6: 1uF
C7, C8: 1.5p
C12: 1u
C121, C131: 27P
CONN1, CONN2, CONN4: CONN_14
D1, D2, D3: L-C170GCT
P2, P3, P5, P6: CONN_1
P7, P8: RS
Q1, Q2, Q4: MOS_N
R1: 1M
R2, R3, R4: 200
R9: 2K2
R231: 56K
R261: 47K
U1: CC2520
U2: MPL115A2
U3: QUARZO
U4: DIPOLO_2_4_V1
l1: BLM15HG102SN1D

Notes on the sheet:
Fixe hole
Fiducial
OpenHardware logo
