emanuelelattanzi/virtual-sense.hardware/1.1.0/TestAudioDSP/VirtualSense_TADSP.sch

## KiCad design 1.1.0/TestAudioDSP/VirtualSense_TADSP.sch (2013-09-16)

Schematic: VirtualSense_TADSP.sch

Parts:
C1, C16, C17, C23: 4u7
C2, C13: 1u
C3, C9, C14, C15, C18, C19, C22: 100n
C4, C5: 470n
C6, C8: NO
C7, C11, C12, C20, C21: 10u
C10: 33p
CONN2, CONN4: CONN_14
L1, L2: BLM21AG151SN1D
M1: MIC
P1: 1V8CC
P2, P3, P5, P6: CONN_1
P4: 1V3CC
P7: DSP
P8: uC
Q1: MOS_N
R1: 2K2
R2: 1K
R3, R13: 4K7
R4: 250K
R5: 14K
R6: 30K
R7, R12, R35: 0
R8, R11: 0-NO
R9: 10K7
R10: 110K
R14, R15: 300
U1: TPS77801
U2: TLV320AIC3204
U3: TPS79501DCQ
U4: DSX321G_12MHZ

Notes on the sheet:
Fixe hole
Fiducial
OpenHardware logo
