emanuelelattanzi/virtual-sense.hardware/1.1.0/TestLayer/VirtualSense_TL.sch

## KiCad design 1.1.0/TestLayer/VirtualSense_TL.sch (2013-07-30)

Schematic: VirtualSense_TL.sch

Parts:
BLTH1: CONN_5
C1: 180pF
C2: 35pF
C3: 280pF
C4, C22, C25: 27pF
C5: 100pF
C6: 220pF
C7: 680pF
C8, C11, C14, C18, C23: 10nF
C9: 10pF
C10, C15, C19, C24: 2.2uF
C12, C13: 1.2nF
C16, C17: 1.5nF
C20, C21: 27uF
CONN1, CONN3, CONN11, CONN31: CONN_14
CONN5: CONN_7
L1: 560nH
L2: 330nH
L3: 150nH
P2, P3, P5, P6, P7: CONN_1
R1, R8, R9: 0
R2, R3, R4, R5, R6: 50K
R7: 100
U1: MICRO_SD
U2: TRF7970A
U5: W7001
X1: 13.56MHz

Notes on the sheet:
Fixe hole
Fiducial
OpenHardware logo
