emanuelelattanzi/virtual-sense.hardware/1.1.0/TestRadio/VirtualSense_RT.sch

## KiCad design 1.1.0/TestRadio/VirtualSense_RT.sch (2013-08-04)

Schematic: VirtualSense_RT.sch

Parts:
BH1620FVC1: U4
C1: 1U
C2, C4, C141, C151, C161, C271: 100n
C3: 47uF 4V
C5: 82p
C6: 1uF
C7: 39p
C8, C10: 1p8
C9: 1p5
C12: 1u
C13: 1p
C121, C131: 27P
CONN1, CONN2, CONN4: CONN_14
D1, D2, D3: L-C170GCT
P2, P3: CONN_1
Q1, Q2: MOS_N
R1: 1M
R2, R3, R4: 200
R5: R5
R6: 0R
R9: 2K2
R231: 56K
R261: 47K
U1: CC2520
U2: MPL115A2
U3: QUARZO
U4: BALUN_ANTENNA_2GHZ4_TI
U5: ANTENNA_EXT_2GHZ4
U6: ANTENNA2GHZ4_TI
l1: BLM15HG102SN1D

Notes on the sheet:
Fixe hole
