emanuelelattanzi/virtual-sense.hardware/(commit log)

2013-07-30 Virtualsense 1.1.0 start project commit
    [VirtualSense_AT-B_Cu.gbl, VirtualSense_AT-B_Mask.gbs, VirtualSense_AT-B_Paste.gbp, VirtualSense_AT-B_SilkS.gbo, VirtualSense_AT-F_Cu.gtl, VirtualSense_AT-F_Mask.gts, VirtualSense_AT-F_Paste.gtp, VirtualSense_AT-F_SilkS.gto]
2013-07-30 standardized folder structure of each layer and created radio test layer
    [VirtualSense_AT-B_Cu.gbl, VirtualSense_AT-B_Mask.gbs, VirtualSense_AT-B_Paste.gbp, VirtualSense_AT-B_SilkS.gbo, VirtualSense_AT-F_Cu.gtl, VirtualSense_AT-F_Mask.gts, VirtualSense_AT-F_Paste.gtp, VirtualSense_AT-F_SilkS.gto]
2013-08-01 created footprints of smd antennas and baluns for radio test layer
    [VirtualSense_RT.brd]
2013-08-04 created radio test layer
    [VirtualSense_RT.brd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]
2013-08-26 created audio DSP test layer
    [VirtualSense_TADSP.brd, VirtualSense_TADSP.dsn, VirtualSense_TADSP.sch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]
2013-08-27 edited schematics of audio DSP test layer adding libraries of CC5535, DC regulator, AIC3204, 12MHz OSC
    [VirtualSense_TADSP.sch, VirtualSense_TADSP_2.sch, VirtualSense_TADSP_3.sch]
2013-08-29 schematics of audio DSP test layer OK, added module on audio DSP test layer brd
    [VirtualSense_TADSP.brd, VirtualSense_TADSP.sch, VirtualSense_TADSP_2.sch, VirtualSense_TADSP_3.sch]
2013-09-09 audio DSP test layer: brd OK, gerber Ok - sent to PCBoards for check
    [VirtualSense_TADSP.brd, VirtualSense_TADSP.dsn, VirtualSense_TADSP.sch, VirtualSense_TADSP_2.sch, VirtualSense_TADSP_3.sch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]
2013-09-10 audio DSP test layer: renamed zip first gerber, added 0-Ohm (R35) for module U2, schematic OK, brd OK, gerber OK - 2nd sent to PCBoards for check
    [VirtualSense_TADSP.brd, VirtualSense_TADSP.csv, VirtualSense_TADSP.sch, VirtualSense_TADSP_2.sch, VirtualSense_TADSP_3.sch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]
2013-09-16 audio DSP test layer: fixed clearance violations, schematic OK, brd OK, gerber OK - 3nd sent to PCBoards check OK
    [VirtualSense_TADSP-test_clearance.dsn, VirtualSense_TADSP.brd, testradio_BOM_description.xls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]
2013-09-16 audio DSP test layer: changed connection ports CONN2 and CONN4, changed uart port to UART2, changed microphone footprint for edge mounting, schematic OK, brd OK, gerber OK - sent to PCBoards for check
    [VirtualSense_TADSP-test_clearance.dsn, VirtualSense_TADSP.brd, VirtualSense_TADSP.csv, VirtualSense_TADSP.sch, VirtualSense_TADSP_2.sch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]
2013-09-20 audio DSP test layer: panelization of last version on one panel 130x130mm
    [VirtualSense_TADSP-pan.csv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]
2014-02-12 clean folder of AudioTrigger layer, create AudioTrigger design package like TI (VirtualSense_AudioTrigger.zip) and create VirtualSenseDSP layer
    [VirtualSense_ADSP-test_clearance.dsn, VirtualSense_ADSP.brd, VirtualSense_ADSP.dsn, VirtualSense_ADSP.sch, VirtualSense_ADSP_2.sch, VirtualSense_ADSP_3.sch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]
2014-02-13 remove VirtualSenseDSP layer from repository
    [VirtualSense_ADSP.sch, VirtualSense_ADSP_2.sch, VirtualSense_ADSP_3.sch]
